xiaominglalala/EI310-3a/21组计划书.md

### 分工：

#### 原则：

- 因为是中文报告，除了留学生每个人都要写报告
- 每个人都要熟悉内容，原理。
- 中国同学每人选择一个部分，外国留学生可以选任意一个加入协助。

#### 分类：

- 代码部分：
  - 理论上最轻松，因为我已经把代码都给出了，根据之前的经验，会花费最少的时间，但希望不要因此而懈怠。
  - 需要看懂代码，明白每个模块的作用，为什么这么设计。
  - 在原本的代码基础上做出改变，不强求要做出什么新功能，但如果是你抄的代码，改改变量，改改注释是应该的。
  - 需要会帮忙调试，因为代码是你看懂的，用那些按键，参数怎么调要知道。
  - 制作阶段不必每次出勤，只需要出勤两次。如果没有什么交互内容，可以一小时后提前离开。但是测试阶段必须每次出勤。

- 焊接辅助与调试：
  - 没有特殊情况，必须每次出勤。
  - 主要负责配合焊接同学与最后的调试。
  - 不需要亲自焊接，但需要适当帮助焊接（比如剪线，找找工具）。
  - 对于原理要用较高的熟悉程度，能在最后的调试环节给予指导，在制作环节能和焊接同学沟通、指挥。

- 焊接：
  - 没有特殊情况，必须每次出勤。
  - 主要负责全部焊接作业和辅助调试。
  - 需要较好的耐心和主动性。因为代码基本都有，所以这个部分的完成程度直接影响整体进度。
  - 不需要全部了解需要调试的内容，但是在出现问题后，能去解决焊接问题。

teamwork时间：

> 初步。我现在不清楚具体开放时间，应该和上学期2a差不多，所以先这么定

周二：下午16：00 - 17：30

周四：下午15：30 - 17：30

周六：下午15：30 - 17：30
