xiaominglalala/EI310-3a/2讲义和技术资料2019-9-11updated/20190927稳压源学生参考电路图.pdf

## Vin+

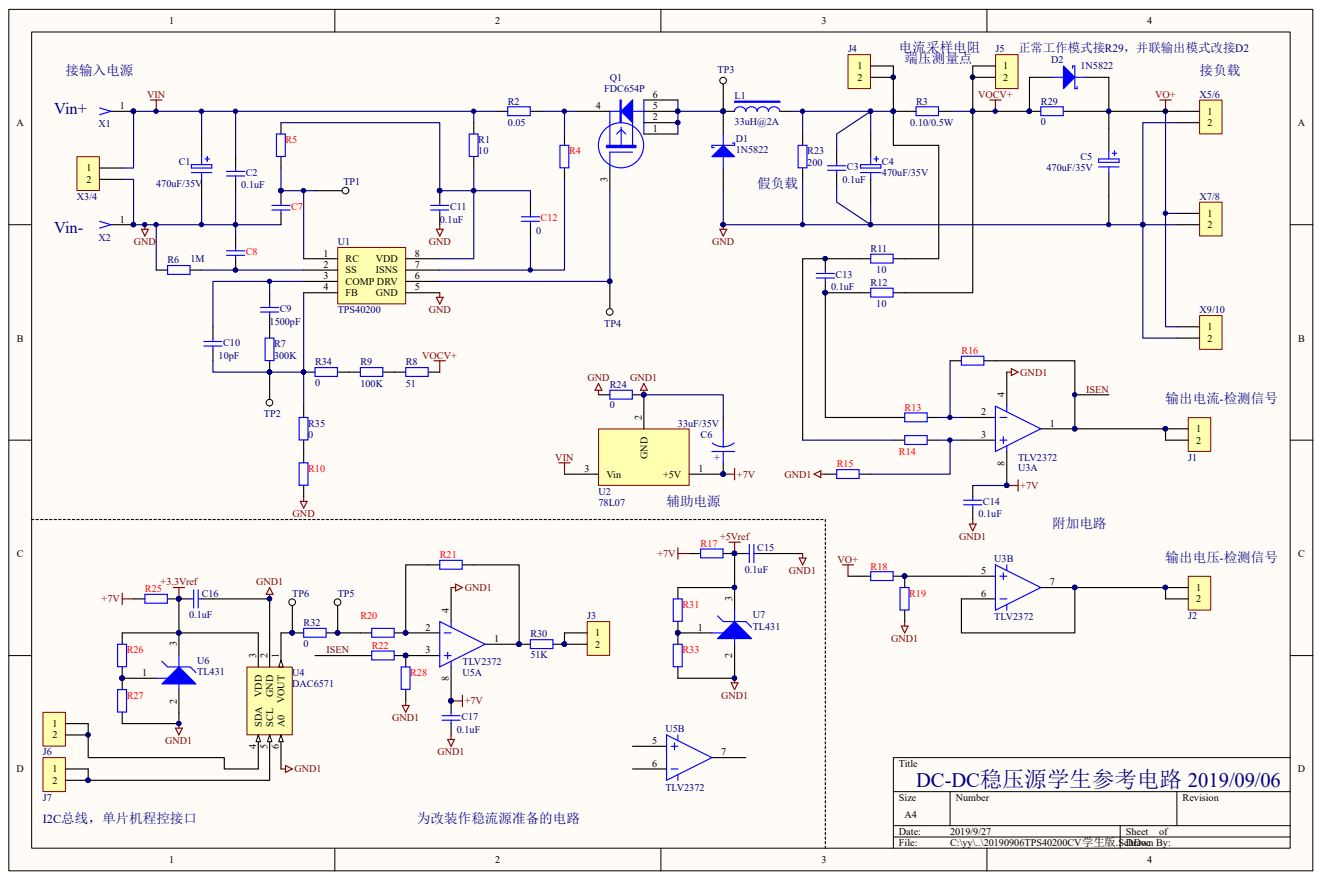
[picture p57: page 1]
