xiaominglalala/EI310-3a/2讲义和技术资料2019-9-11updated/DC-DC电源电路文件/20190906稳流源学生参考电路图.pdf

## Vin+

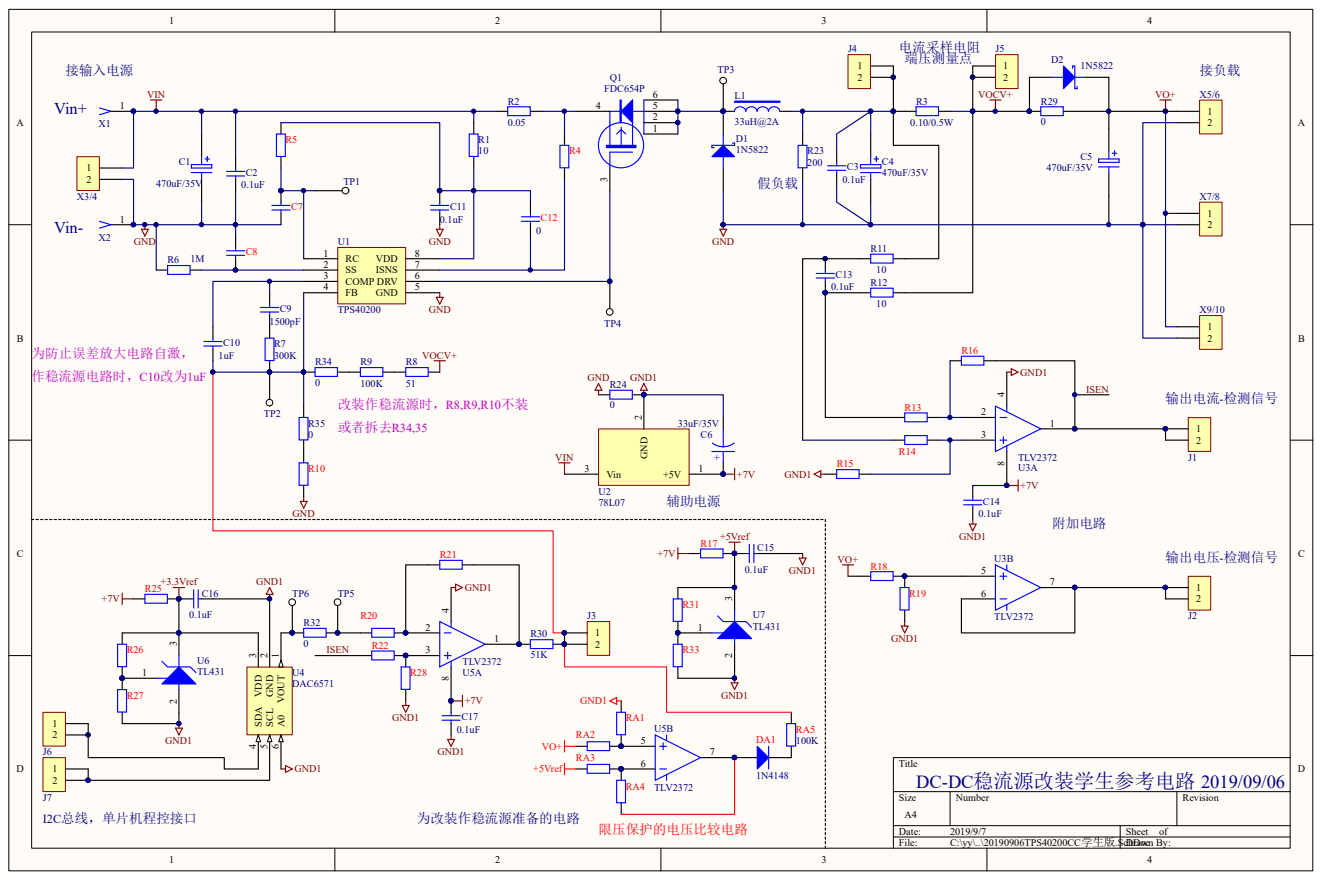
[picture p59: page 1]
