xiaominglalala/EI310-3a/(list of files, drawings)

Other design files:
2讲义和技术资料2019-9-11updated/DC-DC电源电路文件/20190906TPS40200CV学生版.SchDoc
